RabbitMountain/GRBL-CNDY-SHIELD/CndyShield.brd

## EAGLE design CndyShield.brd (2021-08-13)

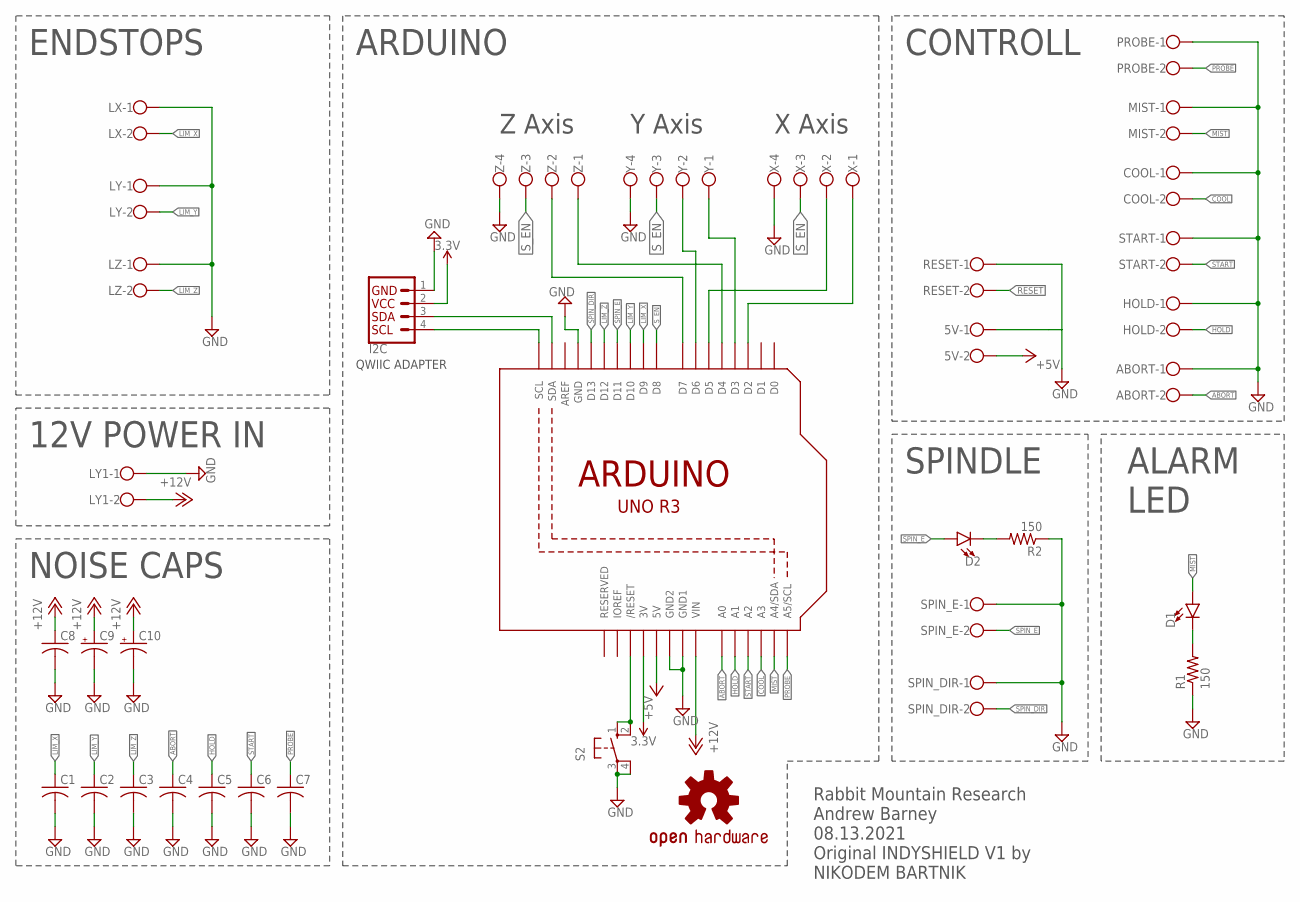
[picture p1: schematic CndyShield.sch]

Parts:
5V: W237-102
ABORT: W237-102
C1, C2, C3, C4, C5, C6, C7, C8: C-US025-024X044; C025-024X044
C9, C10: CPOL-USE1.8-4; E1,8-4
COOL: W237-102
D1, D2: LED5MM; LED_5MM
HOLD: W237-102
I2C: I2C_STANDARD; 1X04
LOGO1: OSHW-LOGOM; OSHW-LOGO-M
LX: W237-102
LY, LY1: W237-102
LZ: W237-102
MIST: W237-102
PROBE: W237-102
R1, R2: 150; 0207/10
RESET: W237-102
S2: 10-XX; B3F-10XX
SPIN_DIR: W237-102
SPIN_E: W237-102
START: W237-102
U1: ARDUINOR3-BPLACE
X: W237-4
Y: W237-4
Z: W237-4

Connections:
3.3V: I2C.2, U1.3V
+5V: 5V.2, U1.5V
+12V: C8.1, C9.+, C10.+, LY1.2, U1.VIN
ABORT: ABORT.2, C4.1, U1.A0
COOL: COOL.2, U1.A3
GND: 5V.1, ABORT.1, C1.2, C2.2, C3.2, C4.2, C5.2, C6.2, C7.2, C8.2, C9.-, C10.-, COOL.1, HOLD.1, I2C.1, LX.1, LY.1, LY1.1, LZ.1, MIST.1, PROBE.1, R1.1, R2.1, RESET.1, S2.3, S2.4 (P1), SPIN_DIR.1, SPIN_E.1, START.1, U1.GND, U1.GND1, U1.GND2, X.4, Y.4, Z.4
HOLD: C5.1, HOLD.2, U1.A1
LIM_X: C1.1, LX.2, U1.D9
LIM_Y: C2.1, LY.2, U1.D10
LIM_Z: C3.1, LZ.2, U1.D12
MIST: D1.A, MIST.2, U1.A4 (A4/SDA)
unnamed: U1.D5, X.2
unnamed: U1.D2, X.1
unnamed: U1.D6, Y.2
unnamed: U1.D3, Y.1
unnamed: U1.D7, Z.2
unnamed: U1.D4, Z.1
unnamed: D1.K (C), R1.2
unnamed: I2C.3, U1.SDA
unnamed: I2C.4, U1.SCL
unnamed: D2.K (C), R2.2
PROBE: C7.1, PROBE.2, U1.A5 (A5/SCL)
RESET: RESET.2, S2.1 (S), S2.2 (S1), U1.RESET (/RESET)
SPIN_DIR: SPIN_DIR.2, U1.D13
SPIN_E: D2.A, SPIN_E.2, U1.D11
START: C6.1, START.2, U1.A2
S_EN: U1.D8, X.3, Y.3, Z.3

Notes on the sheet:
X Axis
Y Axis
Z Axis
ENDSTOPS
SPINDLE
ARDUINO
12V POWER IN
Rabbit Mountain Research Andrew Barney 08.13.2021
QWIIC ADAPTER
Original INDYSHIELD V1 by NIKODEM BARTNIK
CONTROLL
NOISE CAPS
ALARM LED

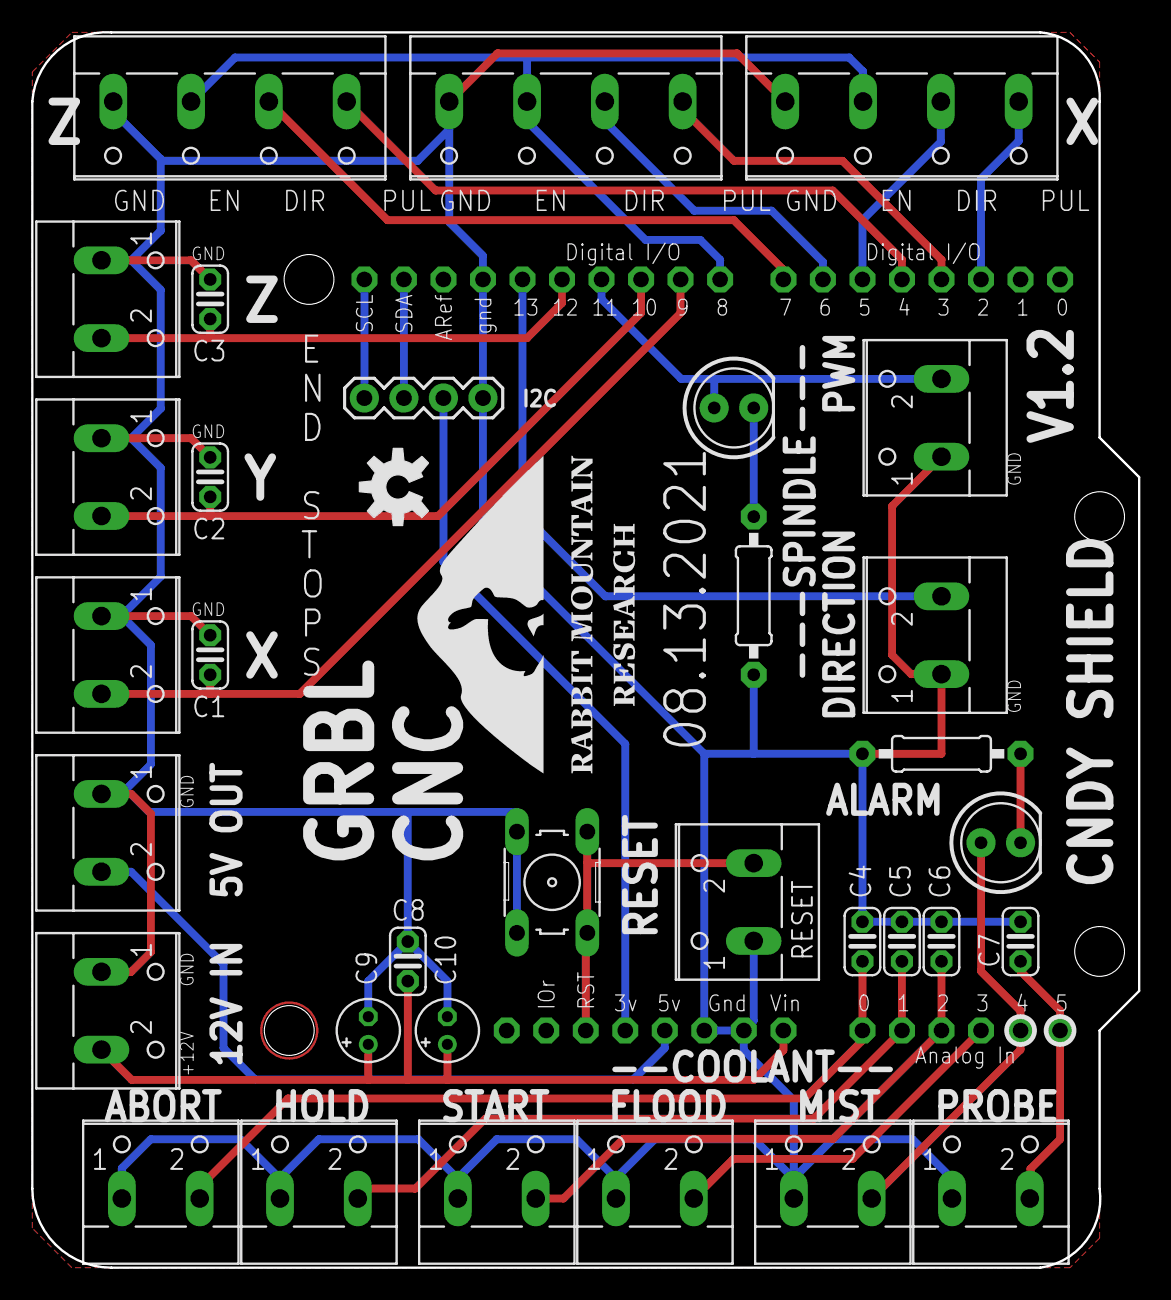
[picture p2: board CndyShield.brd from above]

Board: 2 copper layers, 71.1 x 79.4 mm, 36 parts (0 on the bottom side), 27 nets.

Other parts of the board:
U$2: RMR-SIT-14MM
