RabbitMountain/GRBL-CNDY-SHIELD/(commit log)

2021-08-03 Add files via upload
    V1.1 : remapped analog breakouts. Added filter capacitors. Added Alarm State LED on A4.
    [CndyShield.brd, CndyShield.sch]
2021-08-05 Add files via upload
    minor silkscreen change for Analog 4. Changed LIGHT to MIST to be more consistent with official GRBL port use.
    [CndyShield.brd, CndyShield.sch]
2021-08-08 Add files via upload
    V1.2: Fixed swapped silkscreen text for Spindle PWM and Spindle Direction. Added optional LED to Spindle PWM (pin 11) as an optional safety warning light.
    [CndyShield.brd, CndyShield.sch]
2021-08-11 Add files via upload
    V1.3 Updated Silkscreen. Added OSHW Logo. Noise reduction caps.
    [CndyShield.brd, CndyShield.sch]
2021-08-12 Add files via upload
    CN0DY Shield for GRBL V1.2. Ready for production. Fixed swapped silkscreen with spindle direction and spindle PWM. Added a number of new optional components. Added OSHW logo.
    [CndyShield.brd, CndyShield.sch]
2021-08-13 Add files via upload
    Fixed unrouted air wires. fixed 3.2mm mounting holes.
    [CndyShield.brd, CndyShield.sch]
